DykyiHaban/Doors/TG/README.md

# Проєкт «Двері» — варіант з Telegram (ESP32)

Два окремі варіанти проєкту, які нічого не ділять між собою:

| Варіант | Плата | Де лежить |
|---|---|---|
| Без Telegram | STM32F411 BlackPill | Чат «Проект Двері. Окремо», скетч `door_client` — тут не змінювався |
| З Telegram | ESP32, без BlackPill | Ця папка, скетч `door_esp32_tg/` |

У варіанті з Telegram одна плата ESP32 робить усе: читає датчики, керує MP3-модулем
і пише власнику в Telegram. Потрібен Wi-Fi біля дверей.

## Підключення

Уздовж нижнього краю плати стоїть ряд **гвинтових клемників** (KF301 / DG301, крок 5,08 мм, 17 контактів
упритул). Кожен датчик має свій клемник з усіма потрібними контактами; живлення, земля і сигнали
вже розведені доріжками. Клемники зліва направо:

| Клемник | Контактів | Контакти зліва направо | Пін ESP32 |
|---|---|---|---|
| ХОЛЛ | 3 | GND, VCC (3,3 В), OUT | OUT → GPIO34 (ADC1) |
| РАДАР (LD2410C) | 5 | 5V, TX, RX, OUT, GND | TX радара → GPIO15, RX радара ← GPIO4, OUT → GPIO16 |
| SW-420 | 3 | GND, VCC (3,3 В), DO | DO → GPIO17 |
| ADXL345 (GY-291) | 4 | VCC (3,3 В), SDA, SCL, GND | SDA → GPIO5, SCL → GPIO18 |
| ЗАЧИНЕНО | 2 | SIG, GND | SIG → GPIO19 (тумблер або контакт ригеля на землю) |
| ДИНАМІК | 2 | біля плеєра, правий край | — |

На модулі ADXL345 з'єднайте CS з VCC, а SDO з GND (адреса 0x53). Підписи клем є на складальному кресленні
`boards/esp32_pcb_assembly.svg`; файл `boards/esp32_pcb_labels_1to1.svg` — те саме в масштабі 1:1, його можна
надрукувати й приклеїти на плату.

| Вузол на платі | Пін ESP32 | Примітка |
|---|---|---|
| MP3-модуль, RX | GPIO23 | Через резистор 1 кОм. |
| MP3-модуль, TX | GPIO22 | |
| MP3-модуль, BUSY | GPIO36 (VP) | Низький рівень, поки грає. |
| Індикатор | GPIO2 | Вбудований світлодіод. |
| Живлення | 5V / VIN | 5 В; MP3-модуль теж від 5 В, земля спільна. |

Біля MP3-модуля — конденсатор 470–1000 мкФ по 5 В, як і у варіанті без Telegram.
На модулях ESP32-WROVER піни 16/17 зайняті, тож із цією платою такий модуль не підходить.

**Живлення від 18650.** ESP32 з постійно ввімкненим Wi-Fi споживає в середньому десятки міліампер,
з піками до кількох сотень. Модуль живлення має віддавати на 5 В щонайменше 1 А, а акумулятора
вистачить на значно менший час, ніж у варіанті без Telegram.

## Датчики і режими

Кожен датчик має свій клемник і свій пін, тож на тій самій платі можна поставити будь-який один,
кілька або всі одразу.

| Датчик | Що ловить | Як вмикається |
|---|---|---|
| SW-420 | удар / вібрацію коробки | `USE_SW420 = true` (за замовчуванням; без модуля просто мовчить) |
| ADXL345 | поштовх, мг | `USE_ADXL = true` (за замовчуванням; визначається автоматично) |
| Датчик Холла | зміщення дверей (магніт) | `USE_ANALOG = true` — **тільки** коли датчик підключено, інакше вхід «плаває» |
| Радар LD2410C | людину біля дверей | `SENSOR_MODE` не `MODE_JERK`; визначається автоматично |

Після ввімкнення в Telegram приходить список знайдених датчиків: «Пристрій увімкнувся. Датчики: …».

Удари, які кілька датчиків помітили в межах 300 мс (`JERK_MERGE_MS`), рахуються як один ривок.
`JERK_SENSORS_AGREE = 2` вимагає, щоб удар помітили два різні датчики. Так менше хибних спрацювань,
якщо стоять кілька датчиків; з одним датчиком це налаштування ні на що не впливає.

- **SW-420**: чутливість регулюється підстроювальним резистором на модулі. Кріпиться одним гвинтом
  або двостороннім скотчем на коробку біля ригеля. Пачка імпульсів = одне спрацювання (`VIB_GAP_MS`, `VIB_MIN_EDGES`).
- **ADXL345**: поріг `ADXL_THRESHOLD` (40 мг) підбирається в Serial Plotter (`adxl_mg`). Модуль має
  кріпильні отвори; ставте на коробку або на полотно біля ручки. На полотні потрібен гнучкий кабель через петлі.

Режим вибирається в скетчі константою `SENSOR_MODE`:

| Режим | Коли грає повідомлення | Для яких дверей |
|---|---|---|
| `MODE_JERK` (за замовчуванням) | 2 ривки за 2 с (будь-якими датчиками ривка) | Будь-які; радар не потрібен, живлення від 18650 реальне |
| `MODE_RADAR` | Людина стоїть ближче `RADAR_MAX_CM` (100 см) довше `RADAR_DWELL_MS` (2 с) | Дерев'яні, скляні, пластикові: радар ставиться всередині |
| `MODE_BOTH` | Ривки, і радар бачить людину поруч (зараз або за останні 3 с) | Найменше хибних спрацювань |
| `MODE_ANY` | Будь-що з переліченого | Найчутливіший |

**Радар LD2410C.** Після «зачинено» радар мовчить 30 с (`RADAR_EXIT_MS`), поки власник іде від дверей.
Далі, а також після кожної паузи, він спрацює тільки тоді, коли біля дверей спершу стане порожньо
на 3 с (`RADAR_CLEAR_MS`). Так відвідувач, що чекає після повідомлення, не викликає повтор. Під час старту скетч записує в радар найбільшу
зону (не менше 2 зон, тобто приблизно 1,5–2,25 м) і утримання OUT 1 с. Точну межу 100 см перевіряє
сама прошивка за відстанню з кадрів. Якщо кадрів немає, прошивка читає OUT і надсилає
в Telegram «Радар не надсилає даних».
- Металеві двері та скло з напиленням радар не пробиває: ставте над дверима або збоку на неметалевій стіні.
- Радар споживає порядку 70–80 мА від 5 В постійно, тож від одного 18650 пристрій пропрацює близько доби.
  Для радарних режимів потрібен блок живлення 5 В, а акумулятор лишається як резерв.
- Штори, вентилятори та кондиціонери в зоні дають хибні цілі. Якщо всередині, поки зачинено, лишаються люди,
  радар, спрямований на двері, бачитиме і їх.
- У Serial Plotter видно `radar_cm` (відстань до цілі) і `present` (200, коли людина в зоні).

**Клемник ХОЛЛ** — аналоговий вхід для датчика Холла (наприклад, 49E): увімкніть `USE_ANALOG = true`,
поріг `ANALOG_THRESHOLD` підбирається в Serial Plotter. П'єзо-вузла на платі більше немає.
Один ривок може дати два удари (ригель об планку і повернення), тоді варто поставити `JERKS_TO_TRIGGER = 3`.

## Створення бота

1. У Telegram відкрийте **@BotFather**, надішліть `/newbot`, задайте назву — отримаєте токен.
2. Відкрийте свого нового бота і натисніть **Start**. Без цього бот не має права вам писати.
3. Дізнайтесь ID свого чату: напишіть боту будь-що, потім відкрийте в браузері
   `https://api.telegram.org/bot<ТОКЕН>/getUpdates` і знайдіть число в `"chat":{"id":...}`.
4. Впишіть назву й пароль Wi-Fi, токен та ID у `door_esp32_tg/config.h`.

Токен — це пароль до бота: не надсилайте його в чати й не викладайте `config.h` у відкритий доступ.
Щоб сповіщення отримували кілька людей, додайте бота в групу і вкажіть ID групи (від'ємне число).

## Прошивка

В Arduino IDE: Boards Manager → «esp32 by Espressif Systems», плата «ESP32 Dev Module».
Додаткові бібліотеки не потрібні.

## Сповіщення

| Коли | Текст у Telegram | Як вимкнути |
|---|---|---|
| Двері посмикали (одразу в момент спрацювання) | Хтось смикав зачинені двері — схоже, приходив клієнт. | |
| Радар: людина стояла біля дверей | Біля зачинених дверей хтось стояв — схоже, приходив клієнт. | |
| Радар не надсилає даних (раз після старту) | Радар не надсилає даних… Працюю за виходом OUT. | |
| Спрацювало, але плеєр не заграв | …звукове повідомлення НЕ програлось | |
| Заклад зачинили / відчинили | Заклад зачинено… / Заклад відчинено… | `TG_REPORT_ARMED = false` |
| Подали живлення | Пристрій увімкнувся. | `TG_REPORT_BOOT = false` |

Надсилання йде окремою задачею, тому не зупиняє датчик і звук. Якщо Wi-Fi зник, до 8 подій
чекають у черзі й надходять із приміткою, скільки хвилин тому вони сталися.
`TG_ENABLED = false` лишає тільки звук.

## Перевірка на столі

1. Запишіть на картку файл `/mp3/0001.mp3` (FAT32).
2. Прошийте ESP32, відкрийте Serial Monitor (115200): має з'явитися «Wi-Fi підключено»,
   а в Telegram — «Пристрій увімкнувся. Датчики: …» зі списком знайденого.
3. Замкніть контакти SIG і GND клемника «ЗАЧИНЕНО» — через 3 секунди прийде «Заклад зачинено».
4. Двічі постукайте по столу біля SW-420 / ADXL345 (або двічі проведіть магнітом повз датчик Холла) —
   заграє файл і прийде сповіщення про клієнта.

Пороги підбираються в Tools → Serial Plotter: `adxl_mg` проти `adxl_thr` (ADXL345, 40 мг),
`analog_dev` проти `analog_thr` (датчик Холла, 60 одиниць АЦП), `vibration` (SW-420, 100 під час удару).
АЦП у ESP32 шумніший, ніж у BlackPill, тому стартовий аналоговий поріг вищий, ніж у варіанті без Telegram.

Якщо повідомлень немає, дивіться Serial Monitor. Код помилки **401** або **404** — неправильний
чи незаповнений токен, **400** або **403** — неправильний ID чату або не натиснуто Start,
**0** — немає зв'язку з Telegram.

## Обмеження

- Скетч компілюється під «ESP32 Dev Module» (ядро esp32 3.3.12), але на платі не запускався.
  Розбір кадрів і команди радара написані за протоколом LD2410 і з реальним радаром не перевірялись;
  SW-420 і ADXL345 теж не перевірялись на залізі.
- Сертифікат сервера Telegram не перевіряється (`setInsecure`). Це спрощує налаштування,
  але не захищає від підміни сервера всередині вашої Wi-Fi мережі.
- Команд у боті (наприклад, `/status`) немає — бот лише надсилає сповіщення.
- Плата під ЛУТ для ESP32 — у папках `lut/`, `boards/`, `schemes/` (розрахована на ESP32 DevKit V1 з відстанню між рядами 25,4 мм — звірте зі своїм модулем).
  Плата 100×95 мм, одностороння, без перемичок. Уздовж нижнього краю — ряд гвинтових клемників
  ХОЛЛ, РАДАР, SW-420, ADXL345, ЗАЧИНЕНО; клемник динаміка — біля плеєра.
