DykyiHaban/Doors/main.md

# main — інформація про проекти «Двері»

**Суть:** коли заклад зачинений і хтось смикає двері (або стоїть біля них), пристрій програє звукове
повідомлення (файл `/mp3/0001.mp3` з microSD). Режим «зачинено» вмикається тумблером або контактом
ригеля, замкненим на землю.

Дві незалежні версії, які нічого не ділять між собою.

| | TG (ESP32) | STM32 |
|---|---|---|
| Плата | ESP32 DevKit V1 (30 ніжок) | STM32F411 BlackPill |
| Telegram | **є** — сповіщення власнику | **немає** — лише звук |
| Wi-Fi | потрібен біля дверей | не потрібен |
| MP3-модуль | DFPlayer Mini | HW-247A (DFPlayer Mini) |
| Живлення | шилд 18650 V3, 5 В ≥ 1 А | шилд 18650 V3 |
| Скетч | `TG/firmware/door_esp32_tg/` | `STM32/firmware/door_client/` |
| Стартовий поріг датчика Холла | 60 од. АЦП | 40 од. АЦП |

## Датчики (обидві версії)

Кожен датчик має на нижньому краю плати свій гвинтовий клемник (живлення, земля, сигнали вже розведені) і свій пін:
можна поставити один, кілька або всі одразу без зміни плати.

| Датчик | Вмикання в скетчі | Примітка |
|---|---|---|
| SW-420 (вібрація) | `USE_SW420 = true` (за замовч.) | VCC від 3V3; без модуля вхід підтягнутий і мовчить |
| ADXL345 / GY-291 (акселерометр, I2C) | `USE_ADXL = true` (за замовч.) | визначається автоматично; CS→3V3, SDO→GND; поріг 40 мг |
| Датчик Холла (аналог) | `USE_ANALOG = false` (за замовч.) | вмикати лише з підключеним датчиком |
| Радар LD2410C | `SENSOR_MODE` ≠ `MODE_JERK` | визначається автоматично |

- Удари від різних датчиків у межах 300 мс (`JERK_MERGE_MS`) — один ривок. `JERK_SENSORS_AGREE` — скільки
  різних датчиків мають помітити удар (1 за замовчуванням; 2 — менше хибних).
- Після старту список знайдених датчиків: у Telegram (ESP32) або в Serial Monitor (STM32).
- Клемники KF301 / DG301, крок 5,08 мм, 17 контактів упритул уздовж нижнього краю, зліва направо:
  ХОЛЛ (GND, VCC, OUT) · РАДАР (5 контактів) · SW-420 (GND, VCC, DO) · ADXL345 (4 контакти) · ЗАЧИНЕНО (SIG, GND).
  Порядок контактів радара й ADXL345 на двох платах різний — дивитись підписи на кресленні.
  VCC = 3,3 В, радар — 5 В. Клемник динаміка (2 контакти) — біля плеєра.
- На модулі ADXL345 з'єднати CS з VCC, SDO з GND.
- Підписи клем: складальне креслення в `boards/` і файл `*_labels_1to1.svg` (масштаб 1:1, можна приклеїти на плату).
- Обидві плати односторонні, без перемичок. П'єзо-вузла на платах більше немає.
- Як це розведено: сигнали йдуть над рядом клем «смугами», шина GND — під рядом біля краю (від плеєра правим краєм),
  3,3 В пірнає між площадками клем (крок 5,08 це дозволяє).
- Радар: UART 256000 бод + OUT як запасний канал; живлення 5 В, споживання ≈ 70–80 мА постійно,
  тому для радарних режимів потрібен блок живлення 5 В. Металеві двері радар не пробиває.
- Радар після «зачинено» мовчить 30 с (`RADAR_EXIT_MS`), далі і після кожної паузи чекає, поки біля дверей стане порожньо на 3 с.
- Під час старту скетч записує в радар дальність і утримання OUT 1 с (`RADAR_CONFIGURE`).

## Режими (обидві версії)

| Режим | Спрацювання |
|---|---|
| `MODE_JERK` (за замовчуванням) | 2 ривки за 2 с будь-якими датчиками ривка |
| `MODE_RADAR` | людина ближче 100 см довше 2 с |
| `MODE_BOTH` | ривки + людина поруч (зараз або за 3 с до того) |
| `MODE_ANY` | будь-що з переліченого |

## Логіка спрацювання ривком

- Потрібно 2 ривки за 2 секунди (`JERKS_TO_TRIGGER`, `JERK_WINDOW_MS`).
- Після переходу в «зачинено» 3 с заспокоєння.
- Аналоговий сигнал, що тримається понад 5 с, вважається новим положенням спокою.
- Після повідомлення 60 с пауза.
- Пороги (`ADXL_THRESHOLD`, `ANALOG_THRESHOLD`, підстроювальний резистор SW-420) підбираються на реальних дверях через Serial Plotter.

## TG (ESP32) — з Telegram

| Вузол | Пін |
|---|---|
| ХОЛЛ: GND, VCC, OUT | OUT → GPIO34 |
| РАДАР: 5V, TX, RX, OUT, GND | TX радара → GPIO15, RX радара ← GPIO4, OUT → GPIO16 |
| SW-420: GND, VCC, DO | DO → GPIO17 |
| ADXL345: VCC, SDA, SCL, GND | SDA → GPIO5, SCL → GPIO18 |
| ЗАЧИНЕНО: SIG, GND | SIG → GPIO19 |
| MP3 RX / TX модуля | GPIO23 (через 1 кОм) / GPIO22 |
| MP3 BUSY | GPIO36 (VP) |
| Світлодіод | GPIO2 |

- Сповіщення: пристрій увімкнувся (зі списком датчиків); двері посмикали; біля дверей стояли (радар);
  радар не відповідає; плеєр не заграв; заклад зачинено/відчинено.
- Без Wi-Fi до 8 подій чекають у черзі.
- Wi-Fi і токен бота — у `config.h` (зараз там заготовки; нікому не надсилати).
- Arduino IDE: «esp32 by Espressif Systems», плата «ESP32 Dev Module».
- Детально: `TG/README.md`.

**Плата під ЛУТ:** 100×95 мм, ESP32 + DFPlayer Mini + шилд 18650 V3.
На платі D1, C1 470 мкФ, R1 1 кОм у лінії TX, клемник динаміка; уздовж нижнього краю — ряд клемників датчиків.
Аналоговий вхід (D34) і 5 В для радара йдуть доріжками лівим краєм плати.

## STM32 — без Telegram

| Вузол | Пін |
|---|---|
| ХОЛЛ: GND, VCC, OUT | OUT → PA1 |
| РАДАР: RX, TX, OUT, 5V, GND | RX радара ← PA2, TX радара → PA3 (USART2), OUT → PA4 |
| SW-420: GND, VCC, DO | DO → PB12 |
| ADXL345: VCC, SCL, SDA, GND | SCL → PA8, SDA → PB4 (I2C3) |
| ЗАЧИНЕНО: SIG, GND | SIG → PB5 |
| MP3 RX модуля | PB6 (USART1; TX модуля не потрібен) |
| MP3 BUSY | PB10 (доріжка під модулем BlackPill) |
| Світлодіод | PC13 |

- 11.11.2026 плату перерозведено під ряд клемників; піни скетчу змінено разом із платою. Перемички J1 більше немає.
- Arduino IDE: Generic STM32F4 series → BlackPill F411CE, USB support: CDC (обов'язково).
- Прошивка через STM32CubeProgrammer (DFU) або ST-Link.

**Плата під ЛУТ:** BlackPill + DFPlayer + шилд 18650 V3 (≈ 98×29 мм, координати площадок зняті з даташиту AZ-Delivery, точність ±1 мм).
Права пара площадок шилда робоча, дві ліві — опора. Плата 100×86 мм; BlackPill зсунуто праворуч (x = 10,2 мм),
ліворуч від нього — канал для 6 доріжок (PA1–PA4, 3V3 і 5V до клемників). Уздовж нижнього краю — ряд клемників датчиків.

## Стан (11.11.2026)

| | TG (ESP32) | STM32 |
|---|---|---|
| Скетч компілюється | так (78% пам'яті, ядро 3.3.12) | так (≈ 40 КБ) |
| Запускався на платі | ні | ні |
| Радар, SW-420, ADXL345 перевірялись | ні — код за документацією | ні |
| Плата розведена | так, автоперевірка пройдена | так, автоперевірка пройдена |
| Складальне креслення переглянуте | ряд клемників — так | ряд клемників — так |

## Перед травленням

- **ESP32:** модуль ще не куплено. Відстань між рядами ніжок буває 22,86 / 25,4 / 27,94 мм, плата під 25,4.
  Виміряти модуль, за потреби змінити `BP_ROW` у `TG/schemes/gen_pcb_esp32.py` і перегенерувати. Звірити порядок ніжок.
- **Шилд 18650 V3:** під цією назвою продають різні плати — приміряти. Якщо не збігається, змінити `SH_GRP` і `SH_Y` у генераторі.

## Відкриті питання

- STM32: якщо клон HW-247A не грає з папки `mp3` — перевести на відтворення за номером файлу в корені.
- STM32: перевірити роботу від зарядки без ПК (за потреби `DEBUG_PLOT = false`).
- TG: у боті немає команд (`/status` тощо), лише сповіщення.
- TG: сертифікат Telegram не перевіряється (`setInsecure`).
- Ідея: розпізнавання звуку ривка мікрофоном або сирим сигналом датчика — потребує записів реальних ривків.
