DykyiHaban/Doors/agent.md

# agent — правила роботи з папкою Dveri

## Структура

```
Dveri/
├─ agent.md       — цей файл: правила і домовленості
├─ main.md        — інформація про обидва проекти
├─ TG/            — версія на ESP32, з Telegram
│  ├─ README.md   — підключення, бот, прошивка
│  ├─ firmware/   — скетч door_esp32_tg (+ config.h)
│  ├─ schemes/    — gen_pcb_esp32.py (генератор плати з розмірами)
│  ├─ boards/     — складальне креслення
│  └─ lut/        — мідь для друку 1:1 (PDF A4, SVG)
└─ STM32/         — версія на STM32 BlackPill, без Telegram
   ├─ firmware/   — скетч door_client
   ├─ schemes/    — gen_pcb.py
   ├─ boards/
   └─ lut/
```

## Домовленості

- Усі матеріали обох проектів зберігаються тільки в папці Dveri.
- LUT-файли кладуться в `TG/lut` або `STM32/lut`, залежно від версії.
- Генератори плат (`schemes/*.py`) пишуть результат поруч із собою: після перегенерації
  перекласти PDF/SVG у `lut/` і `boards/`.
- `TG/firmware/door_esp32_tg/config.h` — Wi-Fi і токен бота; не викладати і не вставляти в чат.
- Компіляція — Arduino IDE.
- Проект PS — окремий, до Dveri не стосується.

## Джерела

Матеріали зібрані з чатів гілки «Двері»: «Проект Двері. Окремо» (скетч STM32),
«Плата для ЛУТ з блекпілом та живленням» (плата STM32), «Telegram версія розробка» (ESP32).
