DykyiHaban/Doors/STM32/lut/pcb_LUT_A4.pdf

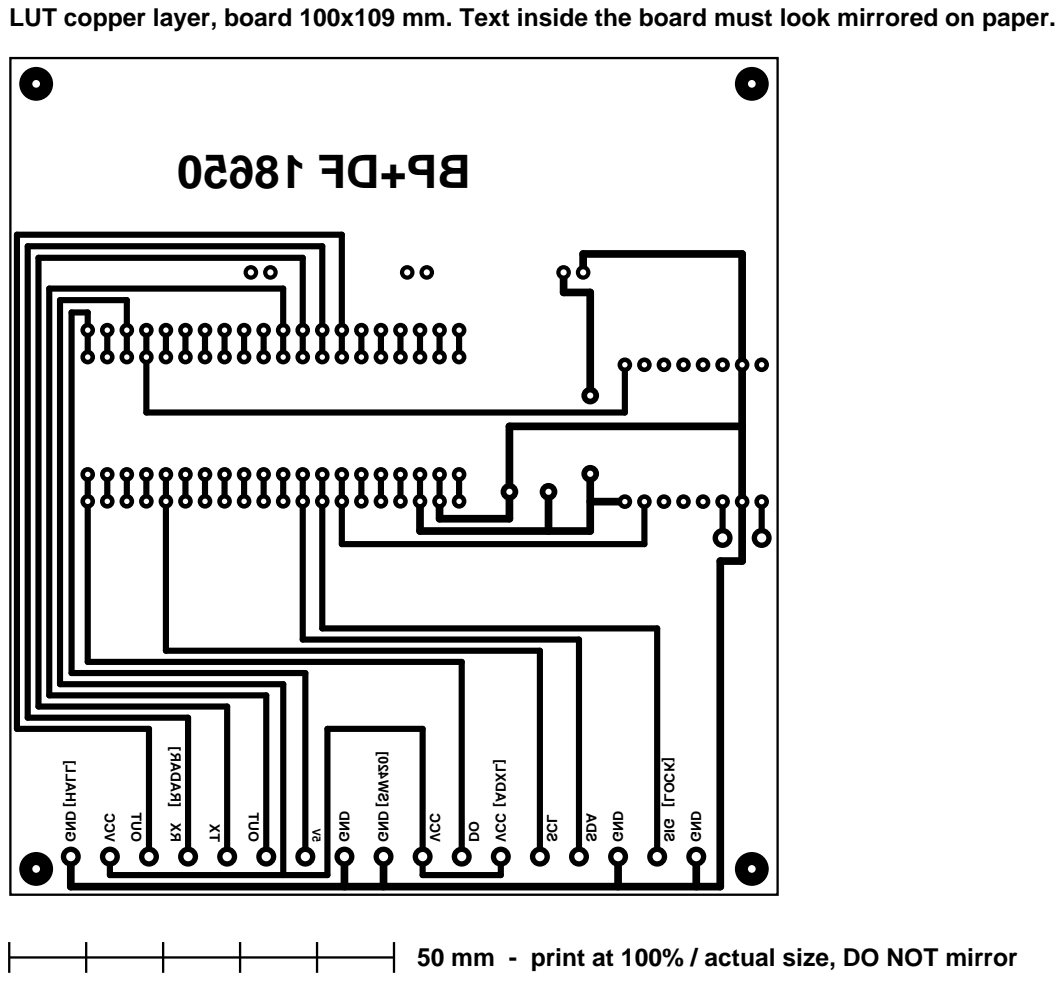
[picture p1: page 1]
GND; VCC; OUT; SCL; SDA; SIG; [HALL]; [RADAR]; [ADXL]; [LOCK]

LUT copper layer, board 100x109 mm. Text inside the board must look mirrored on paper.

50 mm - print at 100% / actual size, DO NOT mirror
