DykyiHaban/Doors/TG/firmware/door_esp32_tg/config.h

// Особисті дані. Заповніть і нікому не надсилайте цей файл (і не вставляйте його в чат).

#define WIFI_SSID      "назва-мережі"
#define WIFI_PASSWORD  "пароль-мережі"

// Токен від @BotFather, вигляду 123456789:AAxxxxxxxxxxxxxxxxxxxxxxxxxxxxxxxxx
#define BOT_TOKEN      "сюди-токен-бота"

// Числовий ID чату власника (як дізнатись — у README.md)
#define CHAT_ID        "сюди-id-чату"
