DykyiHaban/Doors/(commit log)

2026-11-11 Initial commit: door sensor project (STM32 client, ESP32 Telegram notifier)
    Firmware sketches, PCB generator scripts, board/LUT outputs and docs.
    secrets.h is intentionally left out of this commit.
2026-11-11 Update STM32 board and point ESP32 sketch at config.h
    Current STM32 PCB generator, outputs and firmware changes.
    The ESP32 settings header is now referenced as config.h (file not included here).
2026-11-11 Put a labelled screw-terminal row on the board edge for every sensor
    Both boards now carry a row of 5.08 mm screw terminals (KF301/DG301) along
    the bottom edge: HALL (3), RADAR (5), SW-420 (3), ADXL345 (4), ARMED (2),
    plus a 2-pin speaker terminal next to the player. Power, ground and signals
    are routed to each block on the single copper layer with no jumpers.
    - ESP32 board is 100x95 mm, STM32 board is 100x86 mm
    - pins reassigned in both sketches to match the new routing
    - on-board piezo node removed
    - assembly drawings label every terminal; *_labels_1to1.svg is the same
    drawing at 1:1 for printing
2026-11-11 Add terminal labels to the copper layer for LUT printing
    Every screw-terminal contact now has its name in the copper (GND, VCC, OUT,
    TX, RX, SDA, SCL, DO, SIG, 5V) and every block has a bracketed name above
    it ([HALL], [RADAR], [SW420], [ADXL], [LOCK]). Text is mirrored in the file
    so it reads correctly after toner transfer. Labels are included in the
    clearance check (>= 0.5 mm to any track).
    Boards grow to 100x109 mm (ESP32) and 100x100 mm (STM32) to make room.
    [gen_pcb_esp32.py]
2026-11-12 Resize STM32 board to 100x109, add silkscreen sensor dividers and 3D export data
    Regenerated board SVGs and LUT print files for both STM32 and ESP32 boards.
2026-11-12 Add 3D board viewer
